Robo-Linkers/Gesture-controlled-robotic-arm/designs/Schematic_Glove-Robotic-Arm_2025-01-13.pdf

## GND

## PoWer In

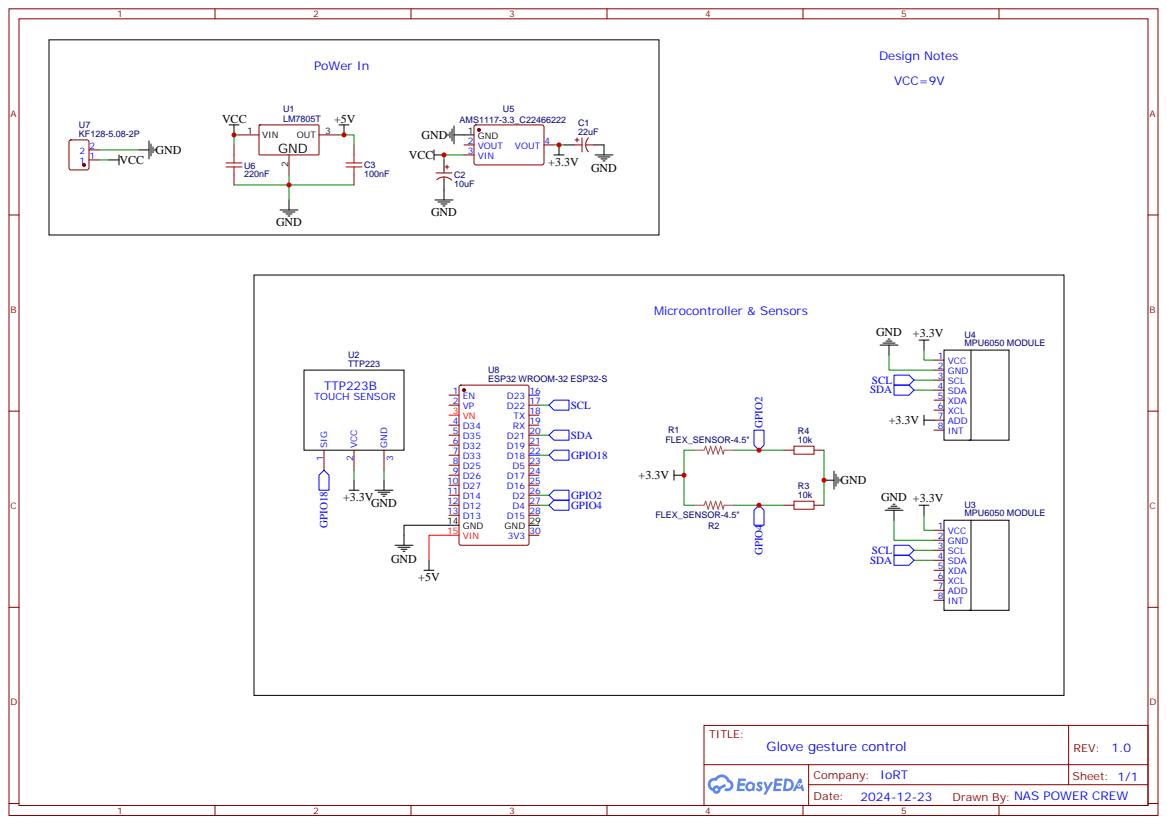
[picture p12: page 1]
