Robo-Linkers/Gesture-controlled-robotic-arm/designs/Schematic_Power-Drive-Controlled-Robotic-Arm_2025-01-13.pdf

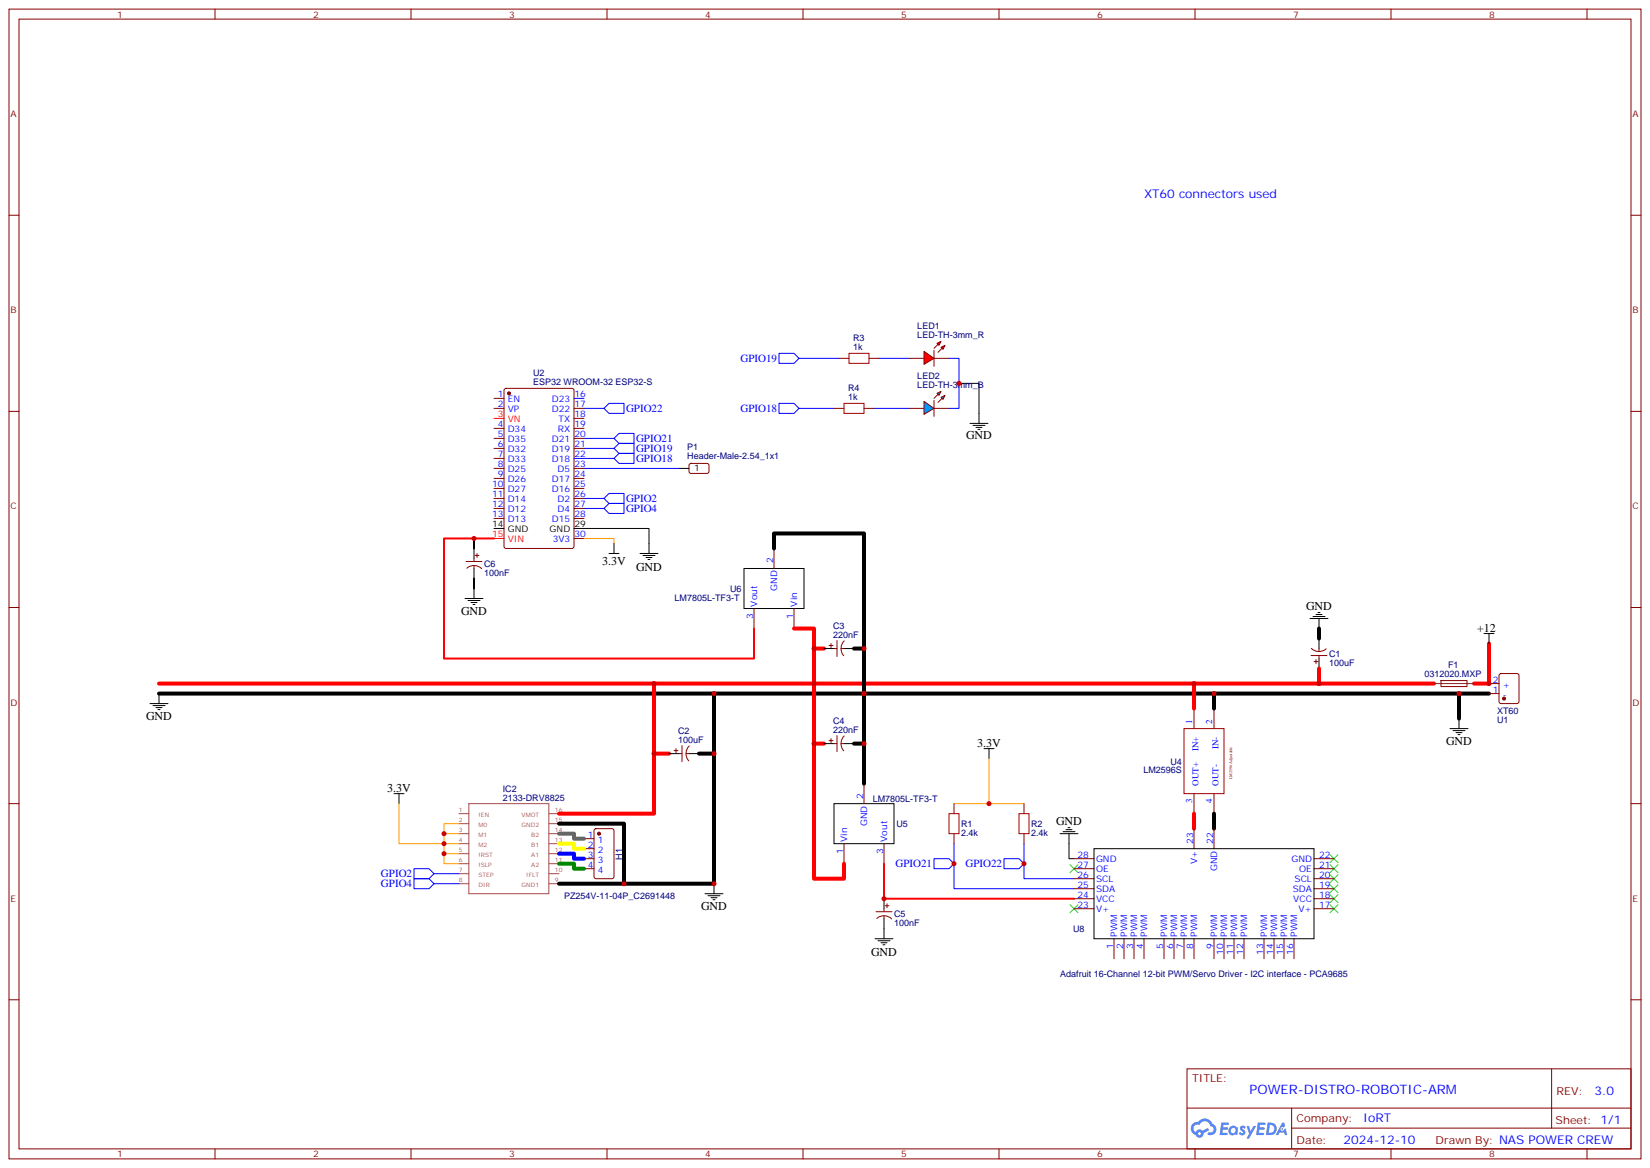
[picture p13: page 1]

Adafruit 16-Channel 12-bit PWM/Servo Driver - I2C interface - PCA9685

Drawn By: NAS POWER CREW
