Robo-Linkers/Gesture-controlled-robotic-arm/(commit log)

2025-02-27 edited power drive log.
2025-03-02 feat: created servo_control.cpp
2025-03-05 fix: servo library and definition, logic in that according to Adafruit_PWMServoDriver.h servo_control.cpp
2025-03-13 updated data_acquisition_and_mqtt.cpp with delay in upload to mqtt using millis() function
2025-03-17 added FSR-based gripper control and improved wrist servo logic
    - Integrated FSR sensor (A0) to control the gripper mechanism.
    - Modified wrist servo logic to operate as a gripper based on FSR input.
    - Preserved original wrist servo logic with comments for reference.
    - Ensured smooth MQTT and Wi-Fi functionality remain unchanged.
2025-03-25 Power Drive Update
2025-04-26 Bill of Materials
2025-04-27 Documents update
    [BASE-v14-solid-edge.cfg]
2025-04-27 Document Updates: BOM.MD, DESIGND.MD, TESTS.MD, Images
2025-05-24 All Documentation Update
    Documentation updated, Final Assembly pictures also updated
2026-11-03 fix(glove): derive Kalman dt from loop interval and fix covariance update
    dt was 0.05 s while the loop runs every 200 ms, so the gyro was integrated with the wrong time step. The covariance update also reused already-modified P[0][0]/P[0][1] when updating P[1][0]/P[1][1]; it now uses the values from before the update. Refs #2 (items 2 and 3).
2026-11-03 test: add host-side Kalman filter check
    Python port of kalmanFilter() run on simulated IMU data, plus source checks on Glove.ino. Passes on this branch and fails on the previous Glove.ino. Needs no hardware.
